tungsten-w/deskpi-tt-riser/docs/images/1U/01_tt_on_riser_1U_total_4U.png

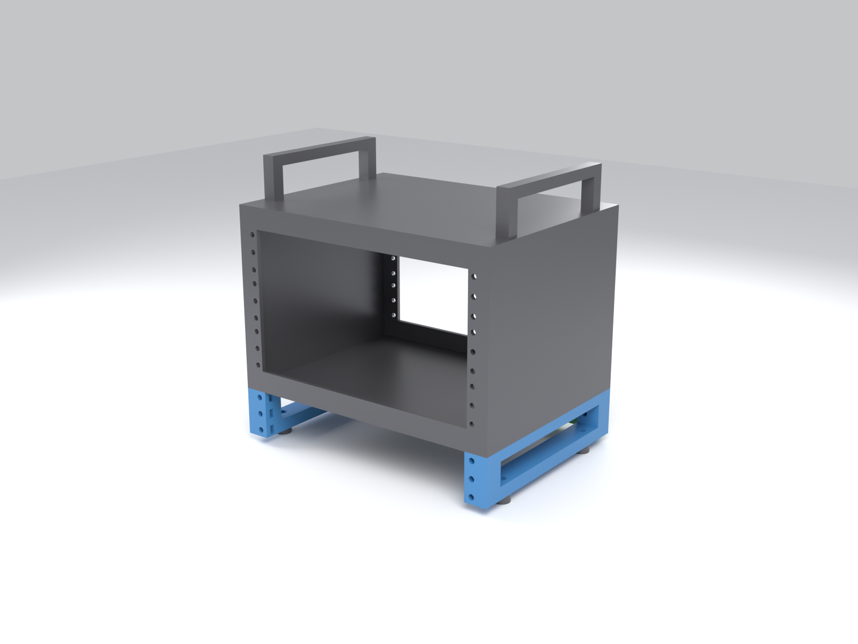
docs/images/1U/01_tt_on_riser_1U_total_4U.png
