tungsten-w/deskpi-tt-riser/docs/images/1U/02_riser_1U_rear.png

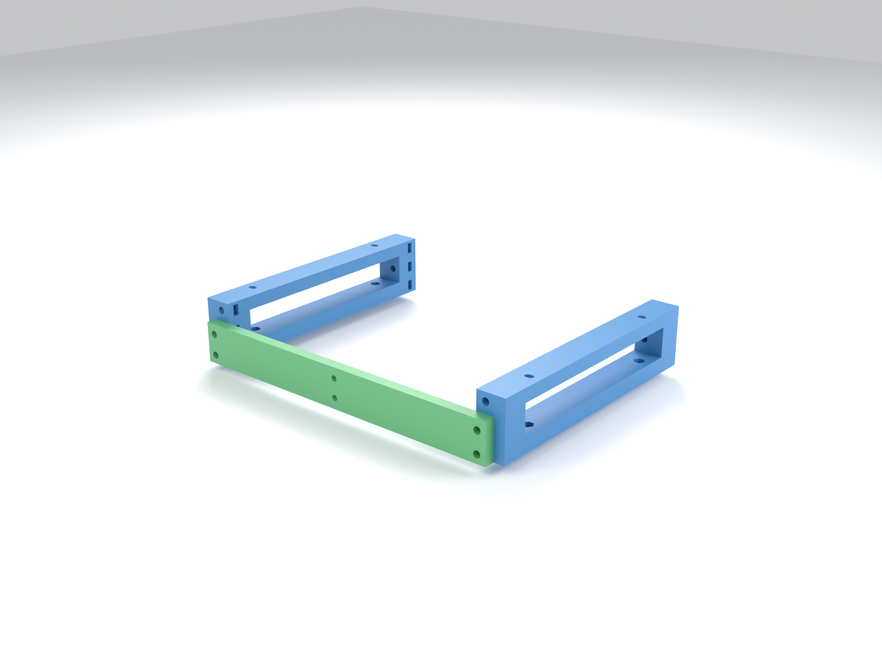
docs/images/1U/02_riser_1U_rear.png
