tungsten-w/deskpi-tt-riser/docs/images/1U/03_front_1U.png

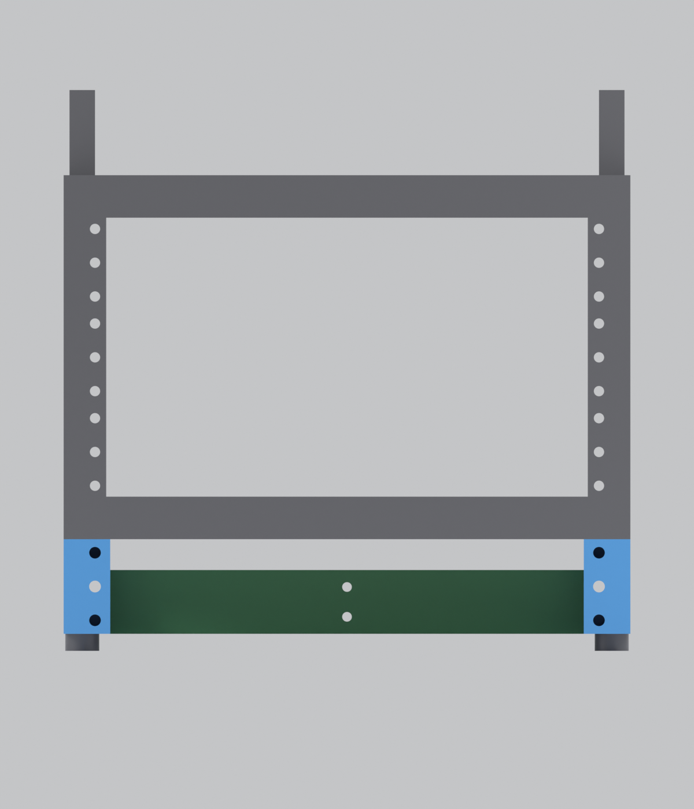
docs/images/1U/03_front_1U.png
