tungsten-w/deskpi-tt-riser/docs/images/1U/04_bed_night_1U.png

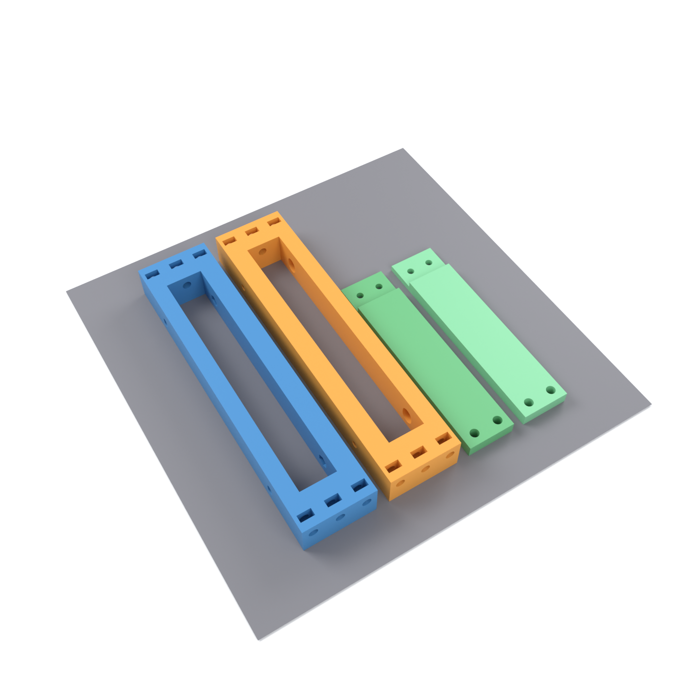
docs/images/1U/04_bed_night_1U.png
