tungsten-w/deskpi-tt-riser/docs/images/2U/02_riser_2U_rear.png

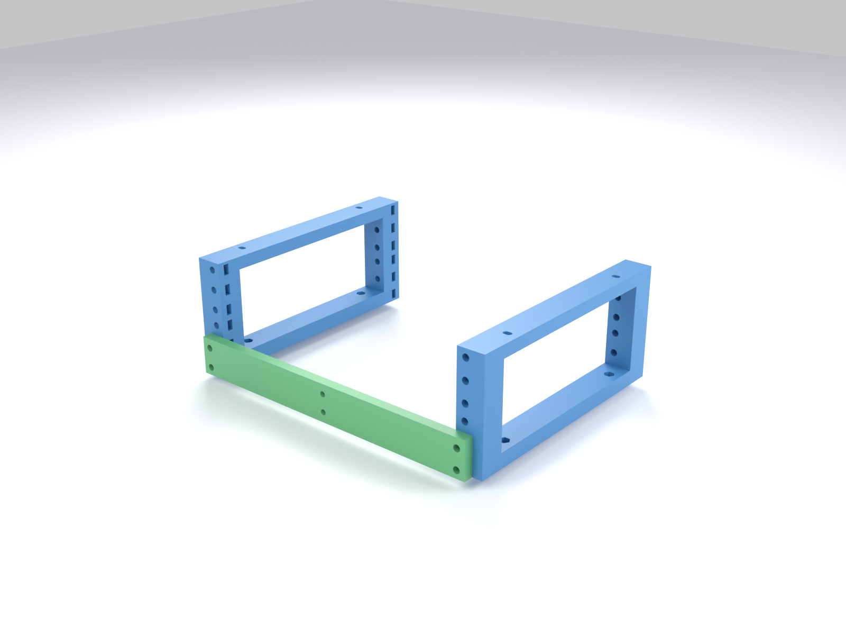
docs/images/2U/02_riser_2U_rear.png
