tungsten-w/deskpi-tt-riser/docs/images/2U/03_front_2U.png

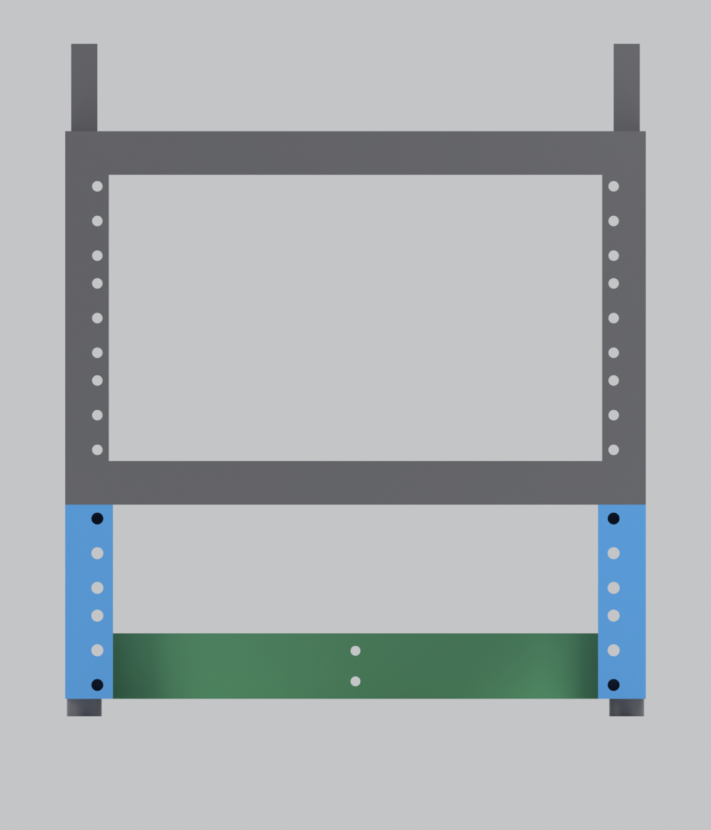
docs/images/2U/03_front_2U.png
