tungsten-w/deskpi-tt-riser/docs/images/2U/04_bed_night_2U.png

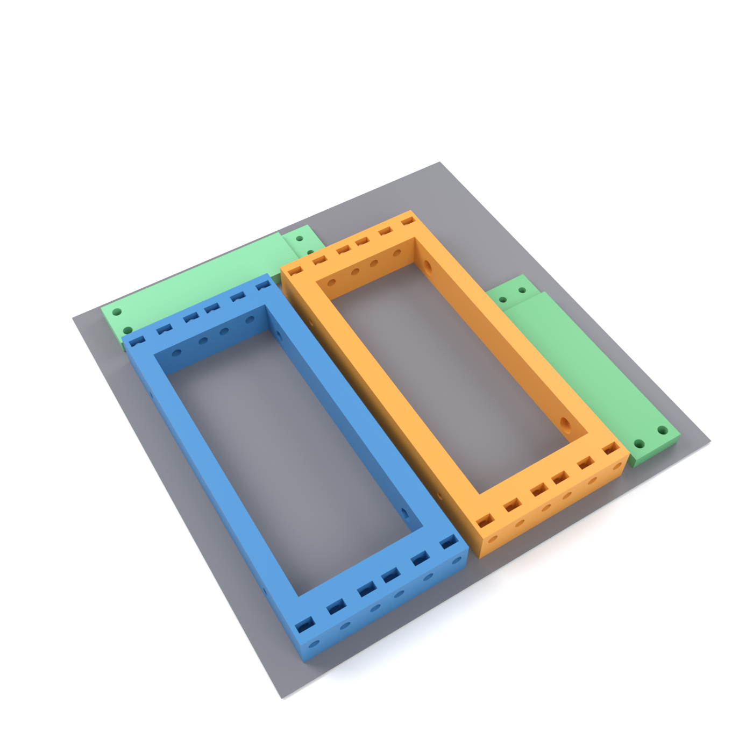
docs/images/2U/04_bed_night_2U.png
