tungsten-w/deskpi-tt-riser/docs/images/3U/02_riser_3U_rear.png

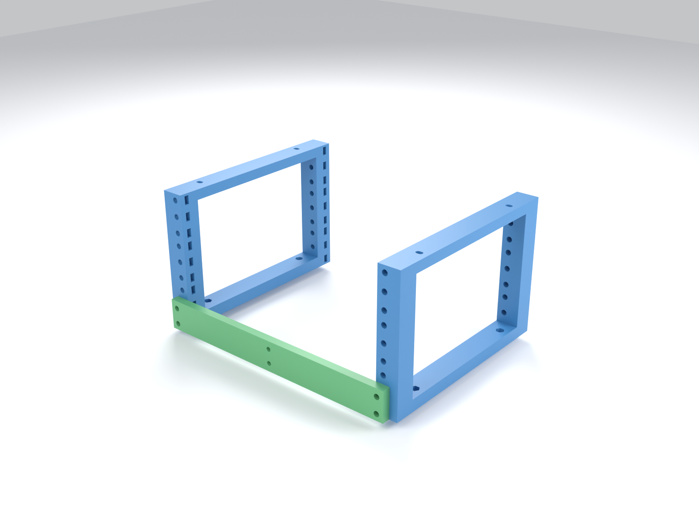
docs/images/3U/02_riser_3U_rear.png
