tungsten-w/deskpi-tt-riser/docs/images/3U/03_front_3U.png

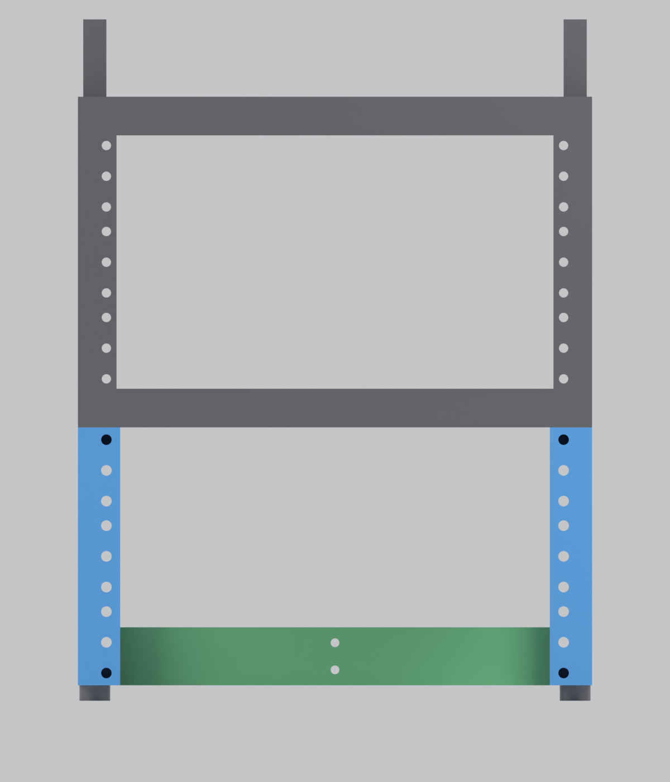
docs/images/3U/03_front_3U.png
