tungsten-w/deskpi-tt-riser/docs/images/3U/04_bed_night_3U.png

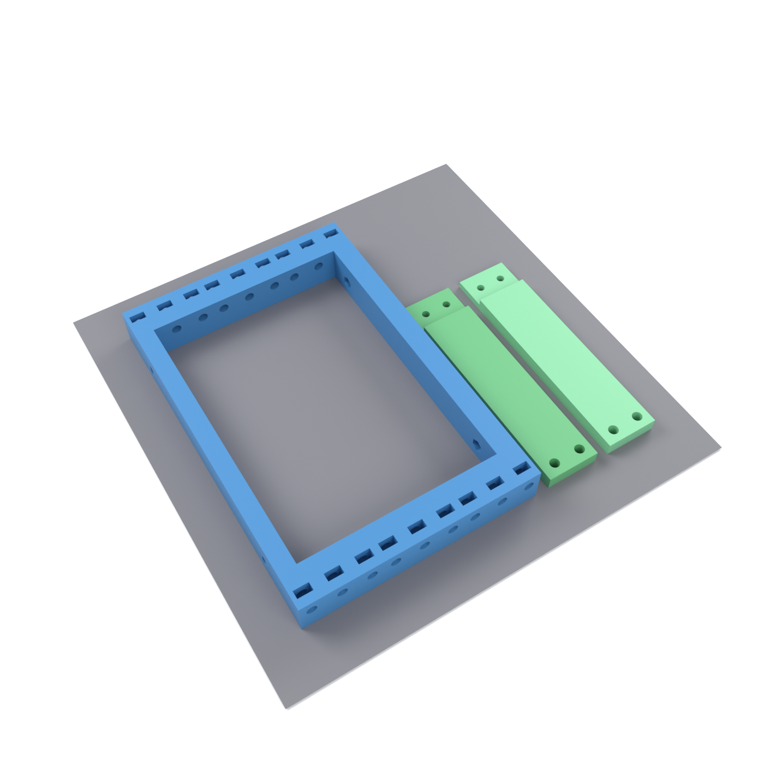
docs/images/3U/04_bed_night_3U.png
