tungsten-w/deskpi-tt-riser/docs/images/3U/05_bed_next_3U.png

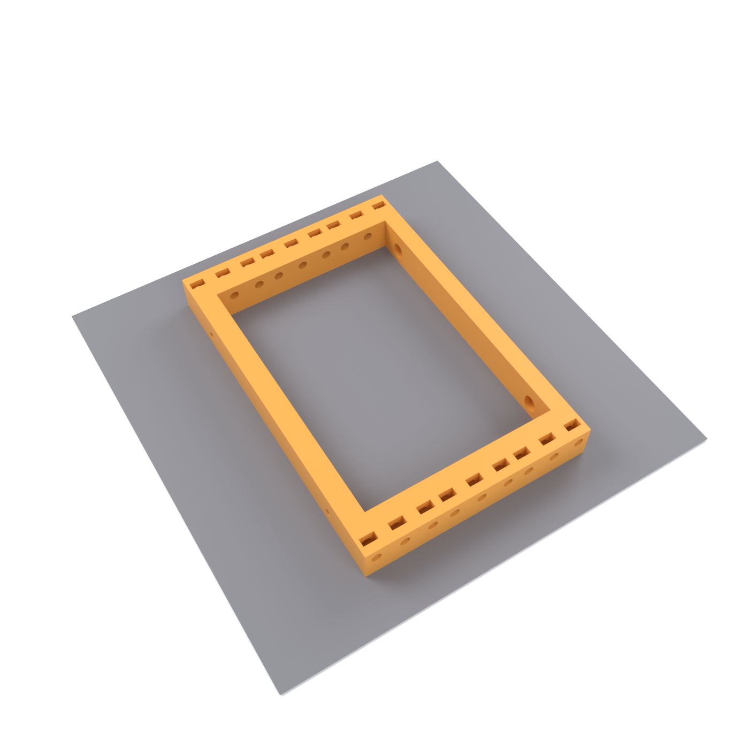
docs/images/3U/05_bed_next_3U.png
