tungsten-w/deskpi-tt-riser/stl/print-sets/centauri-carbon-2/1U/4_rear_brace_A.stl

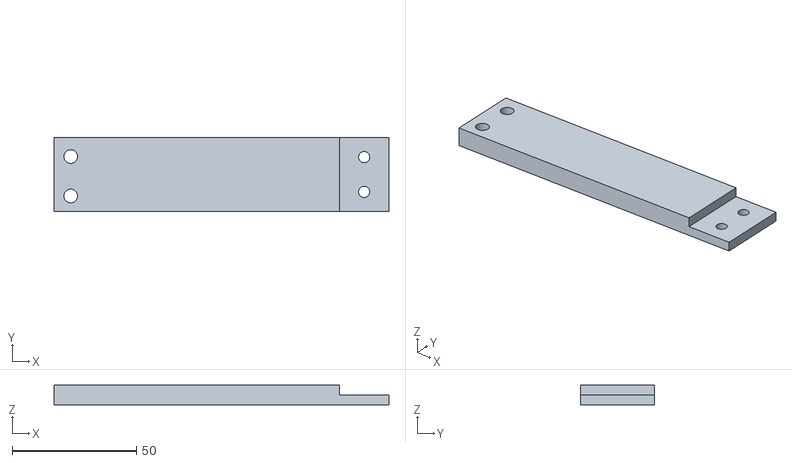
[picture p16: CAD file, 2026-11-09]
stl/print-sets/centauri-carbon-2/1U/4_rear_brace_A.stl
135.0 x 30.0 x 8.00
