tungsten-w/deskpi-tt-riser/stl/print-sets/centauri-carbon-2/2U/1_test_fit.stl

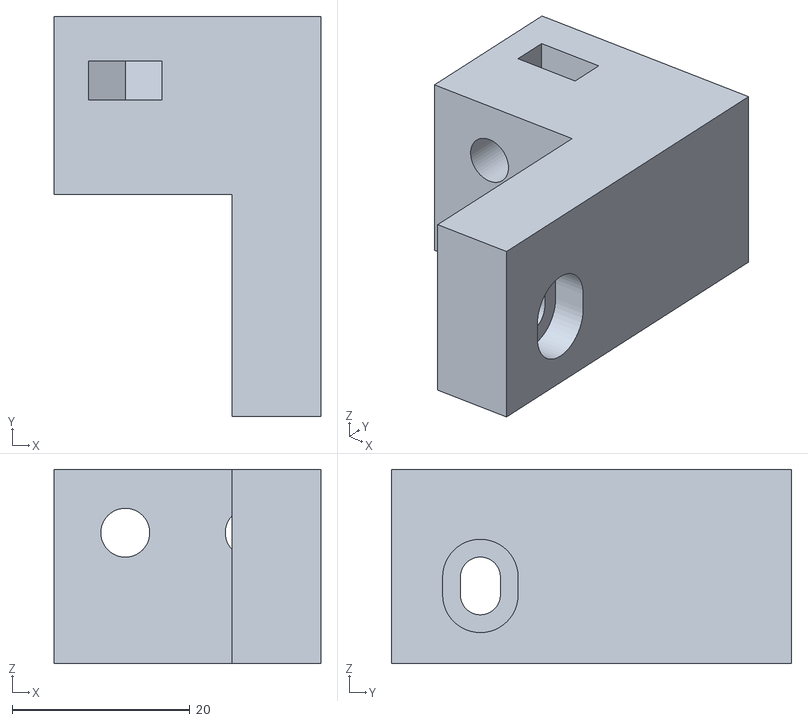
[picture p18: CAD file, 2026-11-09]
stl/print-sets/centauri-carbon-2/2U/1_test_fit.stl
30.0 x 45.0 x 21.9
