tungsten-w/deskpi-tt-riser/stl/print-sets/centauri-carbon-2/3U/3_3U_nuts_right.stl

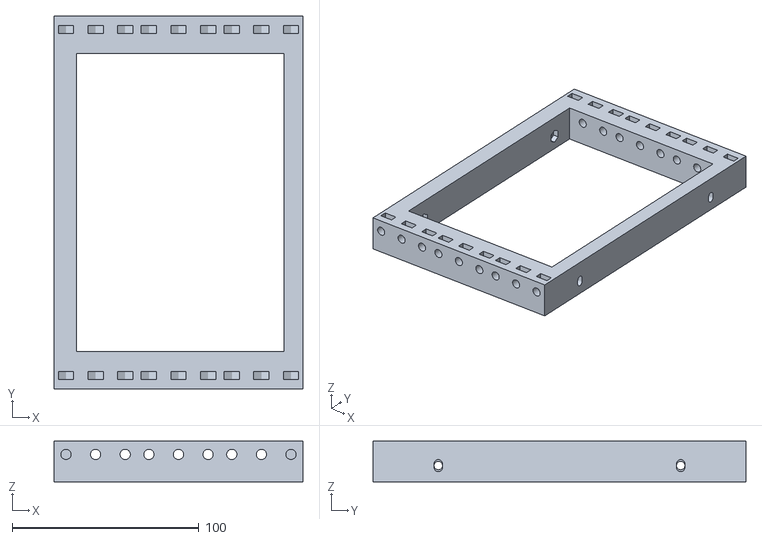
[picture p19: CAD file, 2026-11-09]
stl/print-sets/centauri-carbon-2/3U/3_3U_nuts_right.stl
133.4 x 200.0 x 21.9
