tungsten-w/deskpi-tt-riser/stl/sides/3U_inserts_right.stl

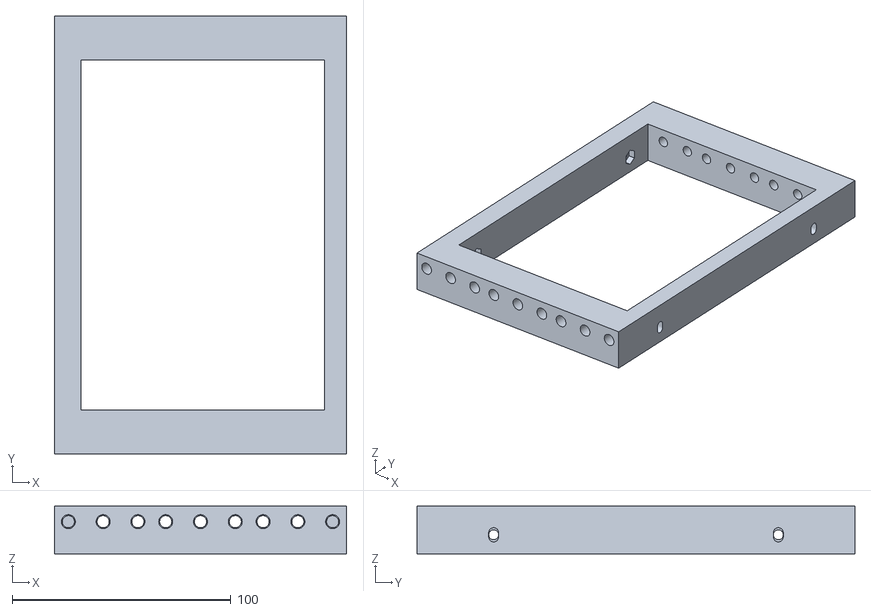
[picture p20: CAD file, 2026-11-09]
stl/sides/3U_inserts_right.stl
133.4 x 200.0 x 21.9
