tungsten-w/deskpi-tt-riser/stl/print-sets/centauri-carbon-2/1U/3_1U_nuts_right.stl

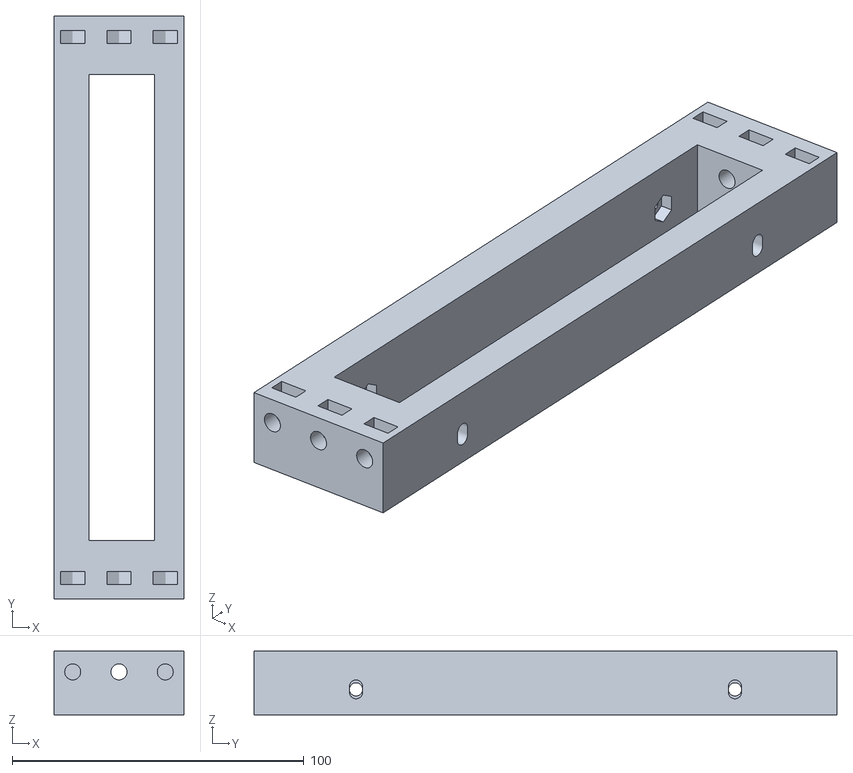
[picture p21: CAD file, 2026-11-09]
stl/print-sets/centauri-carbon-2/1U/3_1U_nuts_right.stl
44.5 x 200.0 x 21.9
