tungsten-w/deskpi-tt-riser/stl/sides/2U_inserts_right.stl

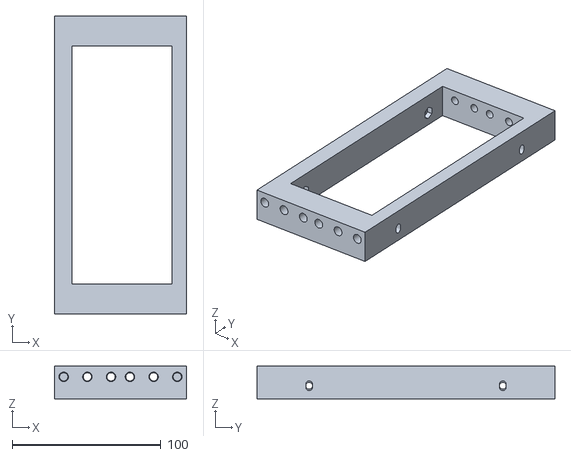
[picture p22: CAD file, 2026-11-09]
stl/sides/2U_inserts_right.stl
88.9 x 200.0 x 21.9
