tungsten-w/deskpi-tt-riser/stl/sides/1U_inserts_right.stl

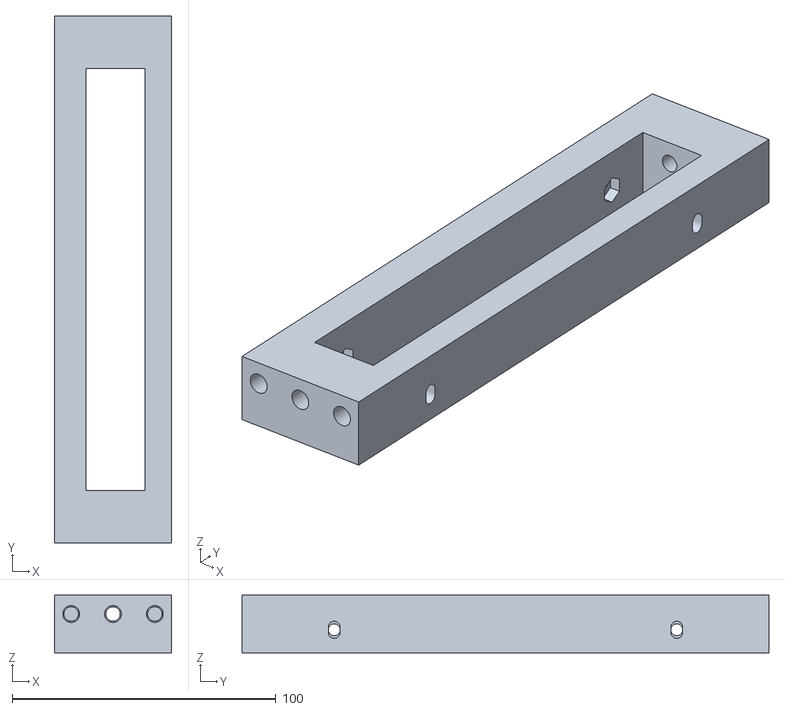
[picture p23: CAD file, 2026-11-09]
stl/sides/1U_inserts_right.stl
44.5 x 200.0 x 21.9
