tungsten-w/deskpi-tt-riser/(list of files, cad)

Other CAD files:
stl/print-sets/centauri-carbon-2/3U/2_3U_nuts_left.stl
stl/print-sets/centauri-carbon-2/1U/2_1U_nuts_left.stl
stl/print-sets/centauri-carbon-2/2U/2_2U_nuts_left.stl
stl/sides/2U_inserts_left.stl
stl/sides/2U_nuts_left.stl
stl/sides/1U_nuts_left.stl
stl/sides/3U_nuts_left.stl
stl/sides/1U_inserts_left.stl
stl/sides/3U_inserts_left.stl
